LorcaSnep/Lorca-SVR-Smol/PCB Production Files/Charger/SVR Lorca Charger BOM.xlsx

Component | Manufacturer Part Number | Digikey Part Number | Mouser Part Number | Designator | Quantity
ATTINY3217-MFR | ATTINY3217-MFR | ATTINY3217-MFRCT-ND | 579-ATTINY3217-MFR | ATTINY | 1
STUSB4500LQTR | STUSB4500LQTR | 497-STUSB4500LQCT-ND | 511-STUSB4500LQTR | STUSB4500 | 1
TPS259631DDAR | TPS259631DDAR | 296-TPS259631DDARCT-ND | 595-TPS259631DDAR | FUSE | 1
APTF1616SURKCGKSYKC | APTF1616SURKCGKSYKC | 754-2149-1-ND | 604-APTF1616KCGKSYKC | LED | 1
MCP1703AT-3302E_CB | MCP1703AT-3302E/CB | MCP1703AT-3302E/CBCT-ND | 579-MCP1703AT3302ECB | 3V3 | 1
USB4105-GF-A | USB4105-GF-A | 2073-USB4105-GF-ACT-ND | 640-USB4105-GF-A | USB_DATA, USB_PWR, USB_RECEIVER | 3
105057-0001 | 1050570001 | WM8672-ND | 538-105057-0001 | RECEIVER | 1
TPD1E10B06DPYR | TPD1E10B06DPYR | 296-30406-1-ND | 595-TPD1E10B06DPYR | D1, D3, D4 | 3
SP0503BAHTG | SP0503BAHTG | F2715CT-ND | 576-SP0503BAHTG | D2, D5 | 2
5.1K 0402 Resistor | RK73H1ETTP5101F | 2019-RK73H1ETTP5101FCT-ND | 660-RK73H1ETTP5101F | R1, R2, R15, R16 | 4
620 Ohm 0402 Resistor | RK73H1ETTP6200F | 2019-RK73H1ETTP6200FCT-ND | 660-RK73H1ETTP6200F | R11 | 1
680 Ohm 0402 Resistor | RK73H1ETTP6800F | 2019-RK73H1ETTP6800FCT-ND | 660-RK73H1ETTP6800F | R9, R10 | 2
715 Ohm 1% 0402 Resistor | RK73H1ETTP7150F | 2019-RK73H1ETTP7150FCT-ND | 660-RK73H1ETTP7150F | R12 | 1
1K 0402 Resistor | RK73H1ETTP1001F | 2019-RK73H1ETTP1001FCT-ND | 660-RK73H1ETTP1001F | R3 | 1
10K 0402 Resistor | RK73H1ETTP1002D | 2019-RK73H1ETTP1002DCT-ND | 660-RK73H1ETTP1002D | R4, R5, R6, R7, R8 | 5
49.9K 0402 Resistor | RK73H1ETTP4992F | 2019-RK73H1ETTP4992FCT-ND | 660-RK73H1ETTP4992F | R14 | 1
200K 0402 Resistor | RK73H1ETTP2003F | 2019-RK73H1ETTP2003FCT-ND | 660-RK73H1ETTP2003F | R13 | 1
47nF X7R 10V 0402 Cap | GRM155R71H473KE14D | 490-10702-1-ND | 81-GRM155R71H473KE4D | C8 | 1
0.1uF 0402 Cap | GRT155R71C104KE01D | 490-GRT155R71C104KE01DCT-ND | 81-GRT155R71C104KE1D | C6, C7 | 2
1uF 0402 Cap | GRT155R61C105KE01D | 490-12255-1-ND | 81-GRT155R61C105KE1D | C1, C2, C5 | 3
C1608X7S1A475K080AC | C1608X7S1A475K080AC | 445-14258-1-ND | 810-C1608X7S1A475KAC | C3, C4 | 2
CL21B106KOQNNNE | CL21B106KOQNNNE | 1276-2872-1-ND | 187-CL21B106KOQNNNE | C9 | 1
GND Pogo Pin | 0908-4-15-20-75-14-11-0 | ED90387-ND | 575-0908415207514 | N/A | 11
Pogo Pin | 0908-3-15-20-75-14-11-0 | ED90417-ND | 575-0908315207514 | N/A | 23
