LorcaSnep/Lorca-SVR-Smol/PCB Production Files/LSM6DSVTR/SVR Lorca V5.0 LSM BOM.xlsx

Component | Manufacturer Part Number | Digikey Part Number | Mouser Part Number | Designator | Quantity
ISP1907-HT | ISP1907-HT | 1786-ISP1907-HT-RSTR-ND | 359-ISP1907-HT-JT | U1 | 1
BQ25185DLHR | BQ25185DLHR | 296-BQ25185DLHRCT-ND | 595-BQ25185DLHR | CHRG | 1
TPS628438DRLR | TPS628438DRLR | 296-TPS628438DRLRCT-ND | 595-TPS628438DRLR | 3V3 | 1
LSM6DSVTR | LSM6DSVTR | 497-LSM6DSVTRCT-ND | 511-LSM6DSVTR | LSM6DSVTR | 1
QMC6309 | QMC6309 | N/A | N/A | MAG | 1
ESDR0502NMUTBG | ESDR0502NMUTBG | ESDR0502NMUTBGOSCT-ND | 863-ESDR0502NMUTBG | USB_PR | 1
TPD1E05U06DPYR | TPD1E05U06DPYR | 296-39341-1-ND | 595-TPD1E05U06DPYR | PWR_PR | 1
ASMB-LTB2-0A333 | ASMB-LTB2-0A333 | 516-4289-1-ND | 630-ASMB-LTB2-0A333 | CHRG_LED | 1
PTS815SJK250SMTR_LFS | PTS815SJK250SMTRLFS | CKN12216-1-ND | 611-PTS815SJK250SMTR | SW0 | 1
EVP-BB1AAB000 | EVP-BB1AAB000 | P124390CT-ND | 667-EVP-BB1AAB000 | RST | 1
CSD17484F4 | CSD17484F4 | 296-47319-1-ND | 595-CSD17484F4 | Q1 | 1
DFE201610E-1R0M=P2 | DFE201610E-1R0M=P2 | 490-18106-1-ND | 81-DFE201610E-1R0MP2 | L1 | 1
781710002 | 781710002 | WM4459CT-ND | 538-78171-0002 | BAT | 1
470 Ohm 5% 0402 | RK73H1ETTP4700F | 2019-RK73H1ETTP4700FCT-ND | 660-RK73H1ETTP4700F | R15 | 1
680 Ohm 5% 0402 | RK73H1ETTP6800F | 2019-RK73H1ETTP6800FCT-ND | 660-RK73H1ETTP6800F | R7 | 1
1K Ohm 5% 0402 | RK73H1ETTP1001F | 2019-RK73H1ETTP1001FCT-ND | 660-RK73H1ETTP1001F | R8, R10 | 2
4.02K Ohm 5% 0402 | RK73H1ETTP4021F | 2019-RK73H1ETTP4021FCT-ND | 660-RK73H1ETTP4021F | R5 | 1
10K Ohm 5% 0402 | RK73H1ETTP1002D | 2019-RK73H1ETTP1002DCT-ND | 660-RK73H1ETTP1002D | R1, R3, R13, R14, R16 | 5
24K Ohm 5% 0402 | RK73H1ETTP2402F | 2019-RK73H1ETTP2402FCT-ND | 660-RK73H1ETTP2402F | R4 | 1
100K Ohm 5% 0402 | RK73H1ETTP1003F | 2019-RK73H1ETTP1003FCT-ND | 660-RK73H1ETTP1003F | R9, R12 | 2
180K 0402 Resistor | RK73H1ETTP1803F | 2019-RK73H1ETTP1803FCT-ND | 660-RK73H1ETTP1803F | R11 | 1
255K Ohm 5% 0402 | RK73H1ETTP2553F | 2019-RK73H1ETTP2553FCT-ND | 660-RK73H1ETTP2553F | R6 | 1
0.1uF 0402 | GRT155R71C104KE01D | 490-GRT155R71C104KE01DCT-ND | 81-GRT155R71C104KE1D | C3, C10 | 2
1uF 0402 | GRT155R61C105KE01D | 490-12255-1-ND | 81-GRT155R61C105KE1D | C11 | 1
4.7uF 0402 | GRT155R61A475ME13D | 490-GRT155R61A475ME13DCT-ND | 81-GRT155R61A475ME13 | C4, C5, C6 | 3
10uF 0402 | GRT155R61A106ME13J | 490-GRT155R61A106ME13JCT-ND | 81-GRT155R61A16ME13J | C1, C2, C7, C8, C9 | 5
