LorcaSnep/Lorca-SVR-Smol/PCB Production Files/Lorca SVR Smol V1.5.xlsx

Component | Manufacturer Part Number | Digikey Part Number | Designator | Quantity | Feeder Reel Size (mm)
ISP1807 | ISP1807-LR-RS | 1786-1019-1-ND | U1 | 1 | 16
LSM6DSVTR | LSM6DSVTR | 497-LSM6DSVTRCT-ND | IMU | 1 | 12 | Reel Width (mm) | Total
IST8306 | iST8306 | 5750-iST8306TR-ND | MAG | 1 | 8 | 8 | 15
BQ24075RGTR | BQ24075RGTR | 296-38874-1-ND | BAT_CHRG | 1 | 12 | 12 | 2
ADP2108ACBZ-3.3-R7 | ADP2108ACBZ-3.3-R7 | ADP2108ACBZ-3.3-R7CT-ND | 3V3 | 1 | 8 | 16 | 2
ESDR0502NMUTBG | ESDR0502NMUTBG | ESDR0502NMUTBGOSCT-ND | USB_PR | 1 | 8
B3U-1000P | B3U-1000P | SW1020CT-ND | SW0 | 1 | 8
ASMB-LTB2-0A333 | ASMB-LTB2-0A333 | 516-4289-1-ND | CHRG_LED | 1 | 8
150040BS73240 | 150040BS73240 | 732-11989-1-ND | STATUS_LED | 1 | 8
781710002 | 781710002 | WM4459CT-ND | BAT | 1 | 16
1N5819W | 1N5819W | 1655-1N5819WCT-ND | D1 | 1 | 8
LQM21PN1R0MC0D | LQM21PN1R0MC0D | 490-4992-1-ND | L2 | 1 | 8
100nF 0402 | GRT155R71C104KE01D | 490-GRT155R71C104KE01DCT-ND | C6, C8 | 2 | 8
4.7uF 0402 | GRT155R61A475ME13D | 490-GRT155R61A475ME13DCT-ND | C1, C2, C10 | 3 | 8
10uF 0402 | GRT155R61A106ME13J | 490-GRT155R61A106ME13JCT-ND | C5, C7, C9, C11 | 4 | 8
1K Ohm 5% 0402 | RK73H1ETTP1001F | 2019-RK73H1ETTP1001FCT-ND | R13 | 1 | 8
10K Ohm 5% 0402 | RK73H1ETTP1002D | 2019-RK73H1ETTP1002DCT-ND | R3, R4, R5, R6, R7, R11, R16, R17 | 8 | 8
100K Ohm 5% 0402 | RK73H1ETTP1003F | 2019-RK73H1ETTP1003FCT-ND | R10, R12 | 2 | 8
180K Ohm 5% 0402 | RK73H1ETTP1803F | 2019-RK73H1ETTP1803FCT-ND | R9 | 1 | 8
