LorcaSnep/Lorca-SVR-Smol/3D Files/Tracker/Main Body Lower.step

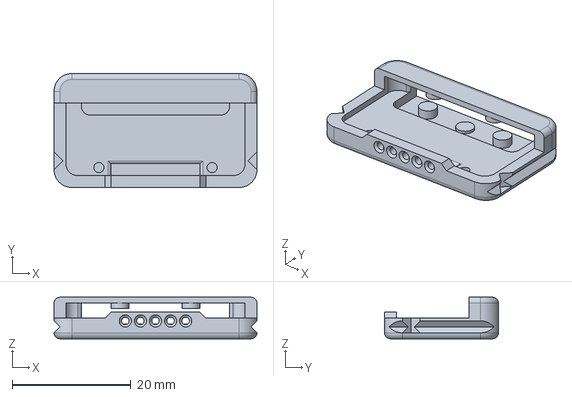
[picture p9: CAD file, 2026-10-28]
3D Files/Tracker/Main Body Lower.step
34.2 x 19.2 x 7.00 mm
