LorcaSnep/Lorca-SVR-Smol/Main Body Upper.step

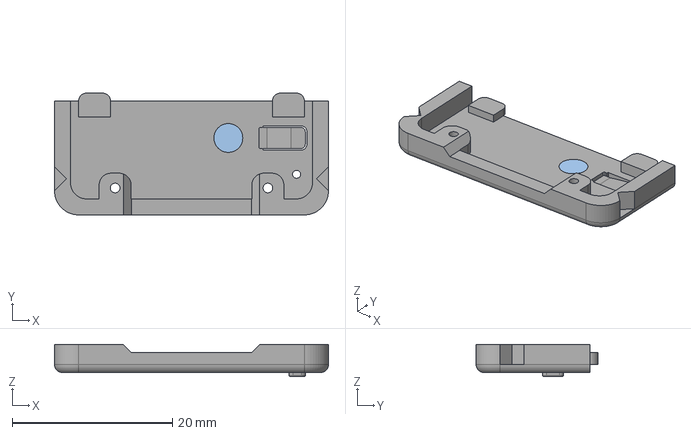
[picture p10: CAD file, 2026-10-28]
Main Body Upper.step
34.2 x 15.2 x 4.00 mm
