LorcaSnep/Lorca-SVR-Smol/3D Files/Charger/Charger Body.step

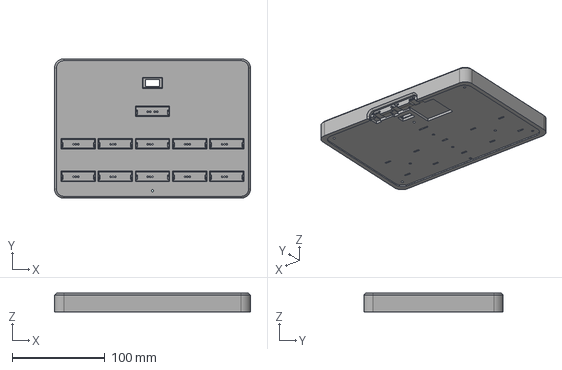
[picture p11: CAD file, 2026-10-28]
3D Files/Charger/Charger Body.step
211.0 x 150.0 x 20.0 mm
