LorcaSnep/Lorca-SVR-Smol/3D Files/Tracker/Bridge V4.step

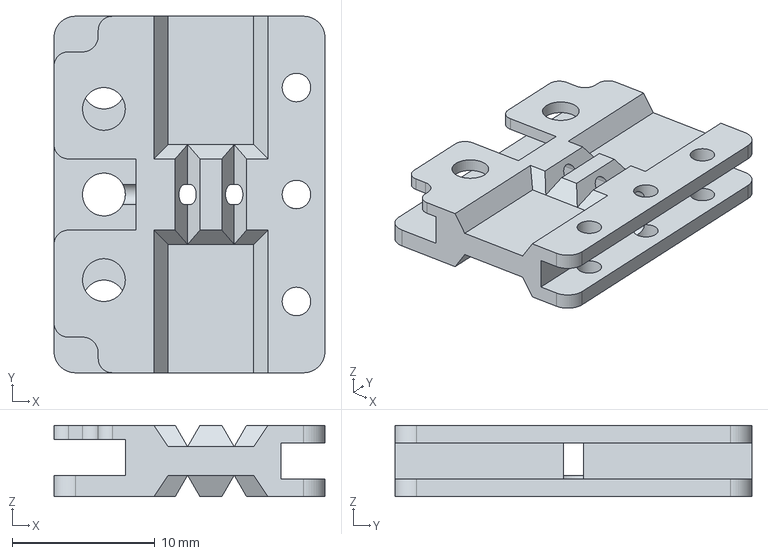
[picture p12: CAD file, 2026-10-28]
3D Files/Tracker/Bridge V4.step
19.0 x 25.0 x 5.00 mm
