LorcaSnep/Lorca-SVR-Smol/Charger Body Bottom Cover.step

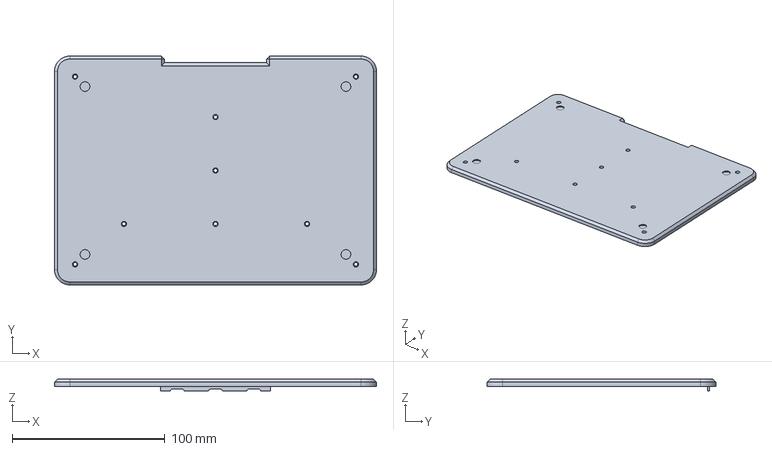
[picture p13: CAD file, 2026-10-28]
Charger Body Bottom Cover.step
211.0 x 150.0 x 7.93 mm
