LorcaSnep/Lorca-SVR-Smol/Battery Body Upper.step

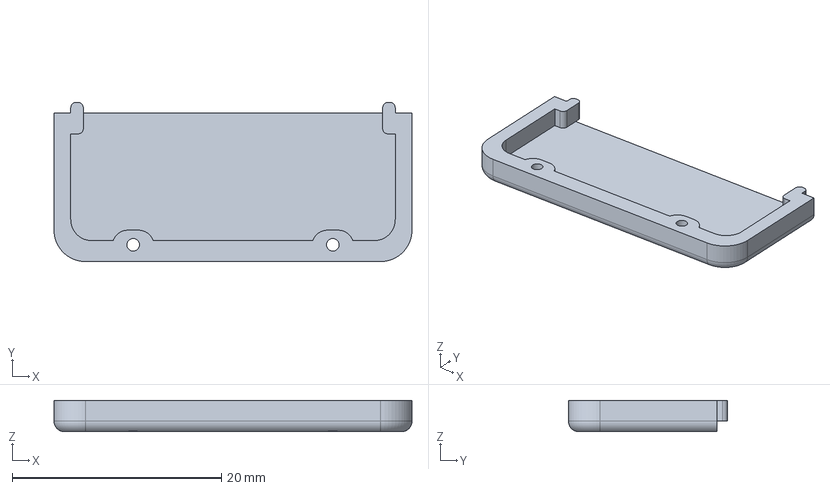
[picture p14: CAD file, 2026-10-28]
Battery Body Upper.step
34.2 x 15.2 x 3.00 mm
