LorcaSnep/Lorca-SVR-Smol/(list of files, cad)

Other CAD files:
3D Files/Tracker/Battery Body Lower.step
