LorcaSnep/Lorca-SVR-Smol/PCB Production Files/LSM6DSVTR/SVR Smol Lorca V5.0 LSM.pdf

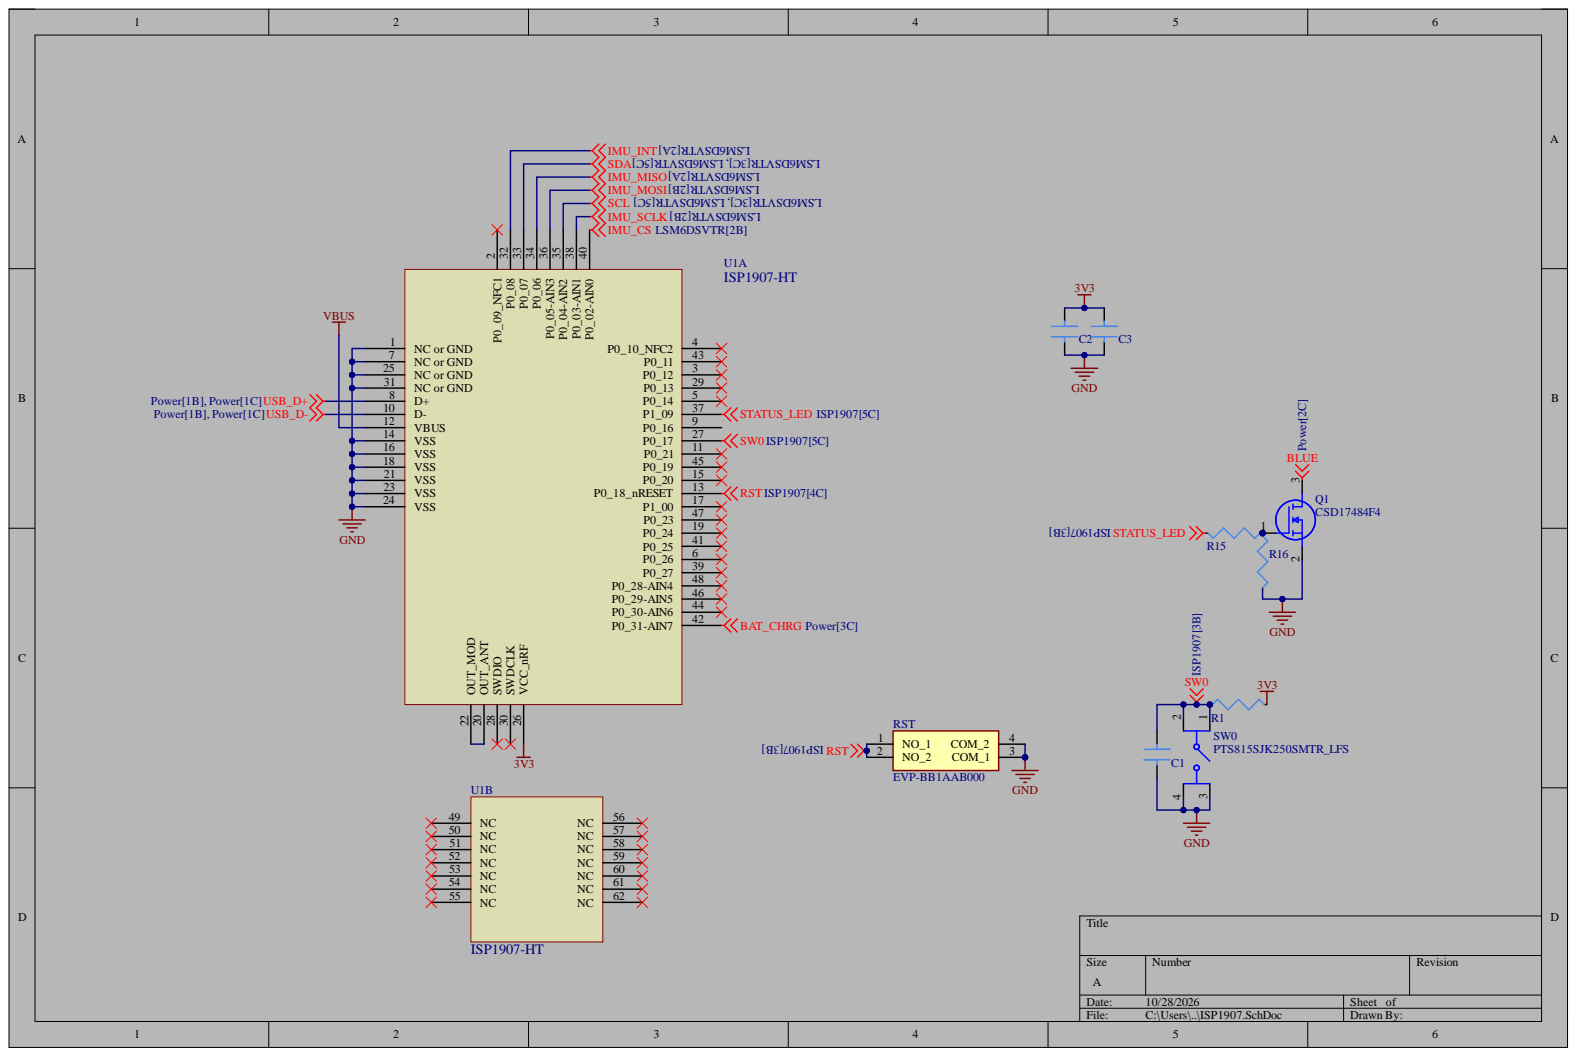
[picture p15: page 1]

IMU_SCLK ] B2[ RTVS D6 MSL SCL ] C5[ RTVS D6 MSL,] C3[ RTVS D6 MSL IMU_MOSI ] B2[ RTVS D6 MSL IMU_MISO ] A2[ RTVS D6 MSL SDA ] C5[ RTVS D6 MSL,] C3[ RTVS D6 MSL IMU_INT ] A2[ RTVS D6 MSL

NC or GND 7
NC or GND 25
NC or GND 31
D+ 8 D- 10 VBUS 12

Size A | Number | Revision

Date: 10/28/2026 | Sheet of
File: C:\Users\..\ISP1907.SchDoc | Drawn By:

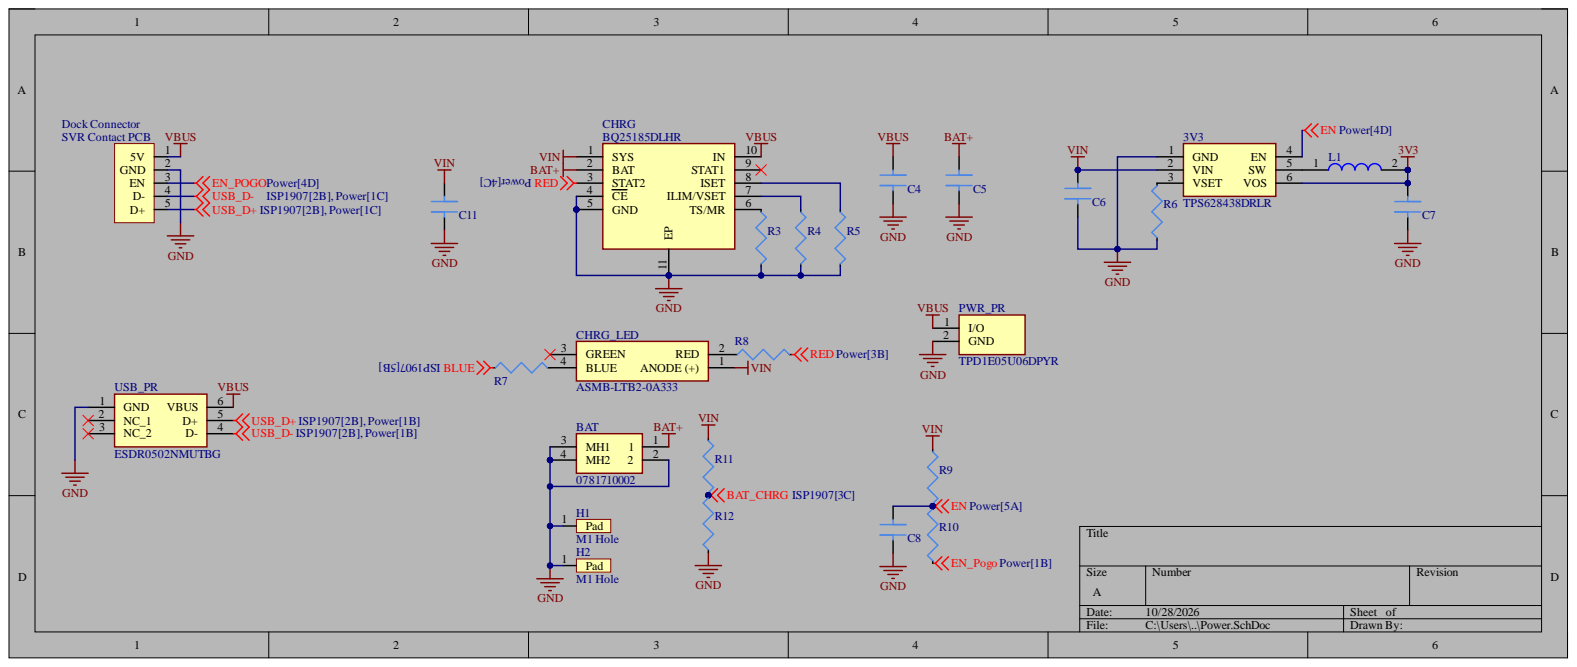
[picture p16: page 2]

Date: 1 0/2 8 /2 0 2 6 | Sheet o f
File: C:\User s\. .\Power .Sch D o c | Drawn B y :

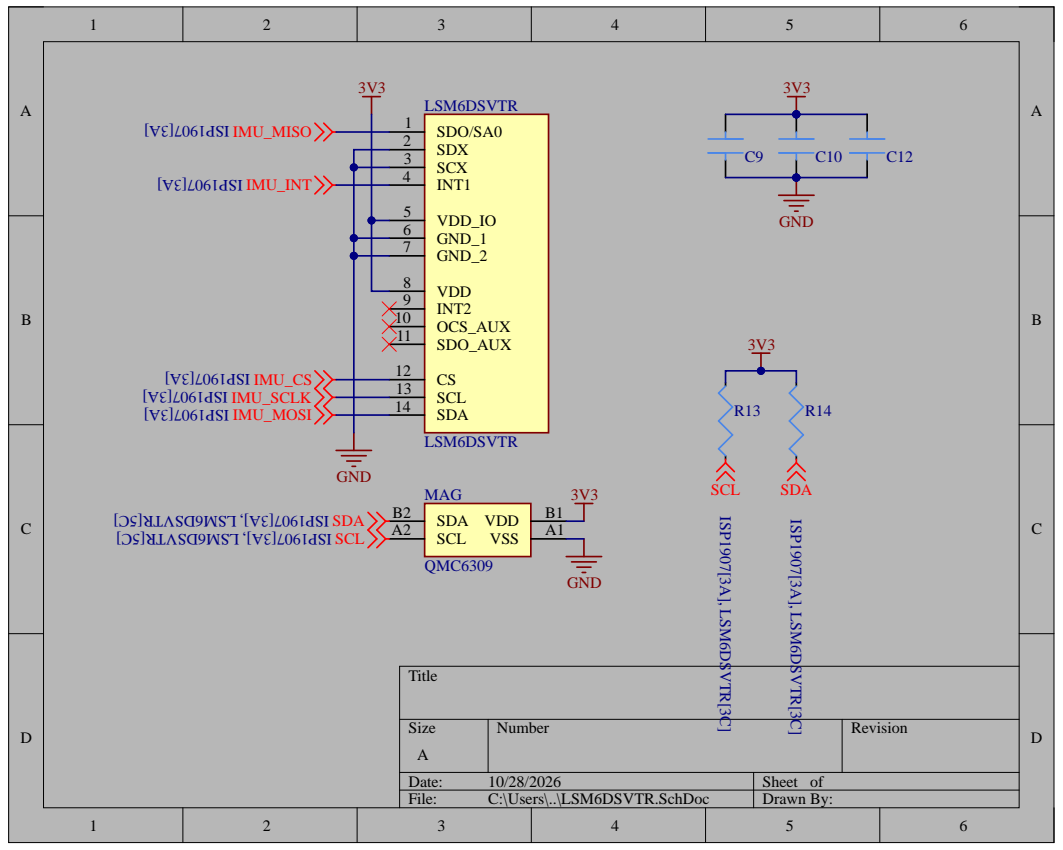
[picture p17: page 3]

SCX 3
INT1 4 VDD_IO 5

GND_1 6

VDD 8

Size A | Number | Revision

Date: 10/28/2026 | Sheet of
File: C:\Users\..\LSM6DSVTR.SchDoc | Drawn By:
