LorcaSnep/Lorca-SVR-Smol/PCB Production Files/ICM-45686/SVR Smol Lorca V5.0 ICM.pdf

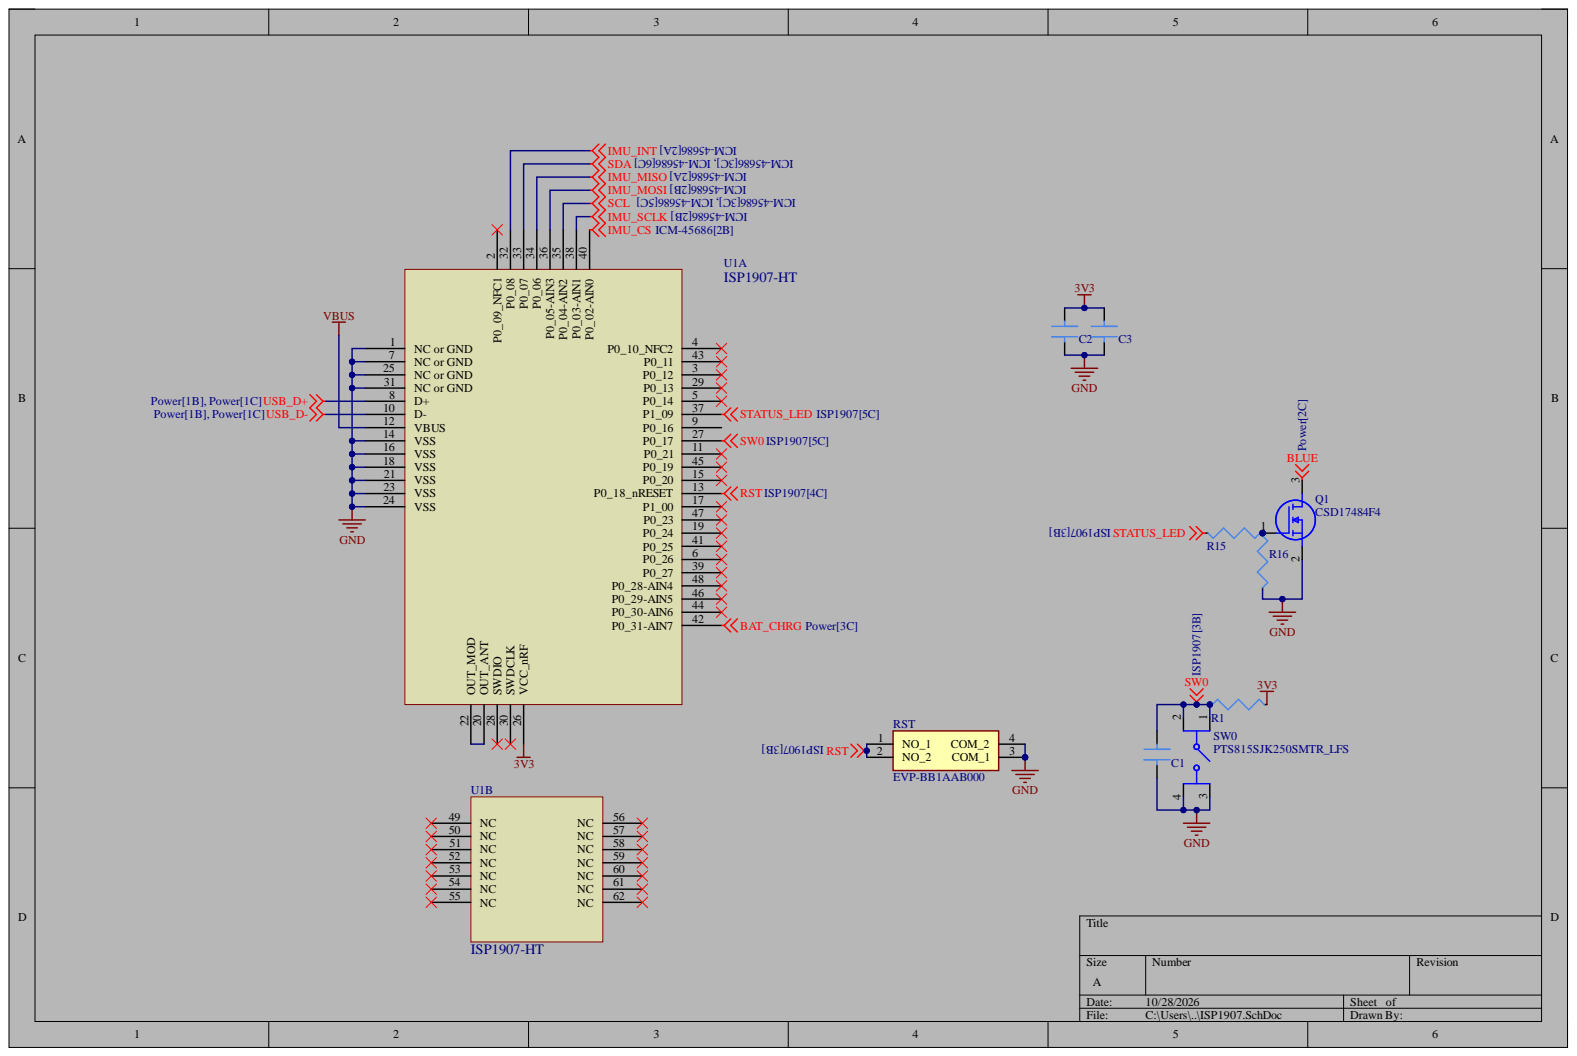
[picture p18: page 1]

IMU_SCLK ] B2[ 68654- MCI SCL ] C5[ 68654- MCI,] C3[ 68654- MCI IMU_MOSI ] B2[ 68654- MCI IMU_MISO ] A2[ 68654- MCI SDA ] C6[ 68654- MCI,] C3[ 68654- MCI IMU_INT ] A2[ 68654- MCI

NC or GND 7
NC or GND 25
NC or GND 31
D+ 8 D- 10 VBUS 12

Size A | Number | Revision

Date: 10/28/2026 | Sheet of
File: C:\Users\..\ISP1907.SchDoc | Drawn By:


Date: 1 0/2 8 /2 0 2 6 | Sheet o f
File: C:\User s\. .\Power .Sch D o c | Drawn B y :

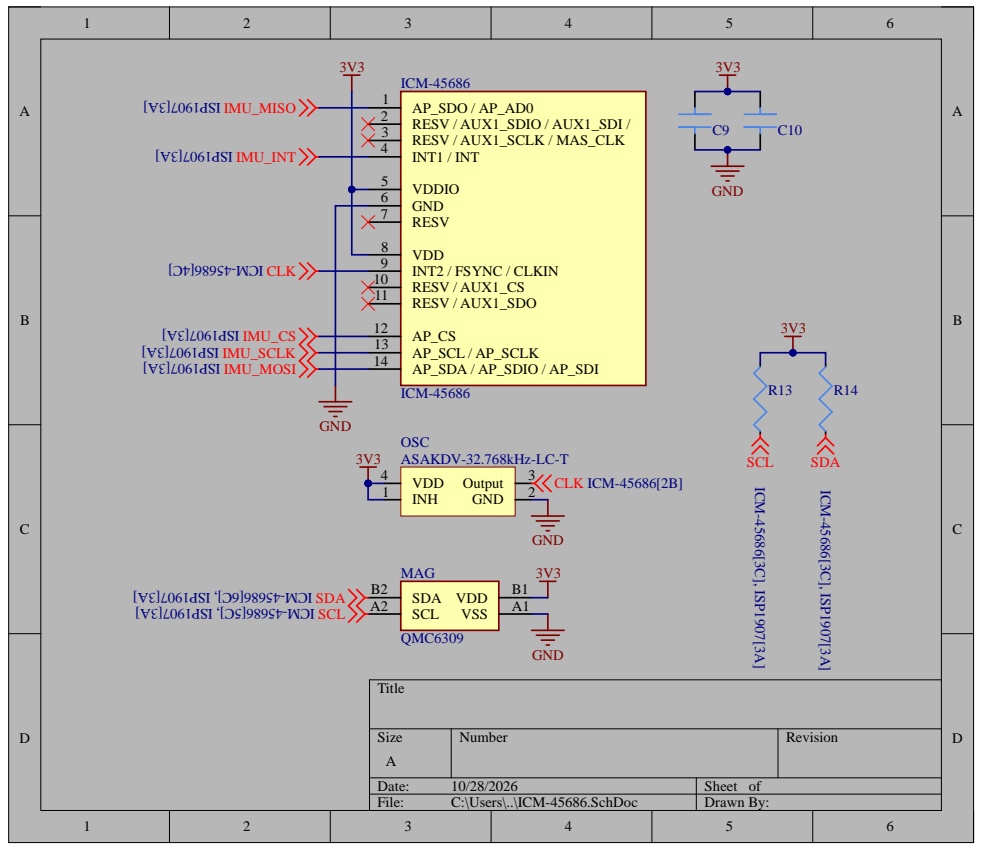
[picture p19: page 3]

Size A | Number | Revision

Date: 10/28/2026 | Sheet of
File: C:\Users\..\ICM-45686.SchDoc | Drawn By:
