LorcaSnep/Lorca-SVR-Smol/PCB Production Files/Charger/SVR Smol Lorca Charger.pdf

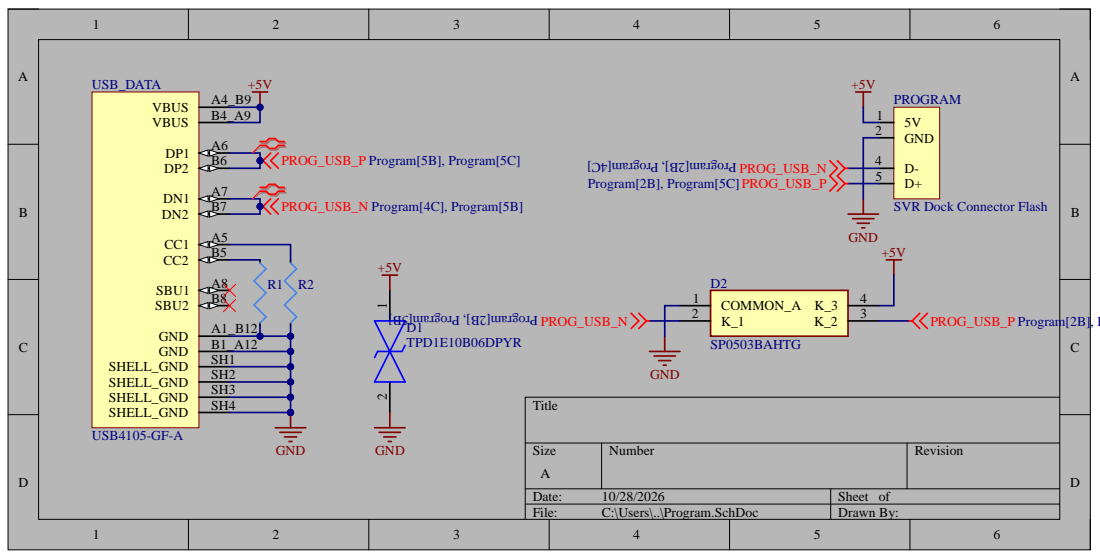
[picture p20: page 1]

Size A | Number | Revisio n

Date: 1 0/2 8/2 0 2 6 | Sheet o f
File: C:\Users\..\Pro gram.SchDo c | Drawn By :

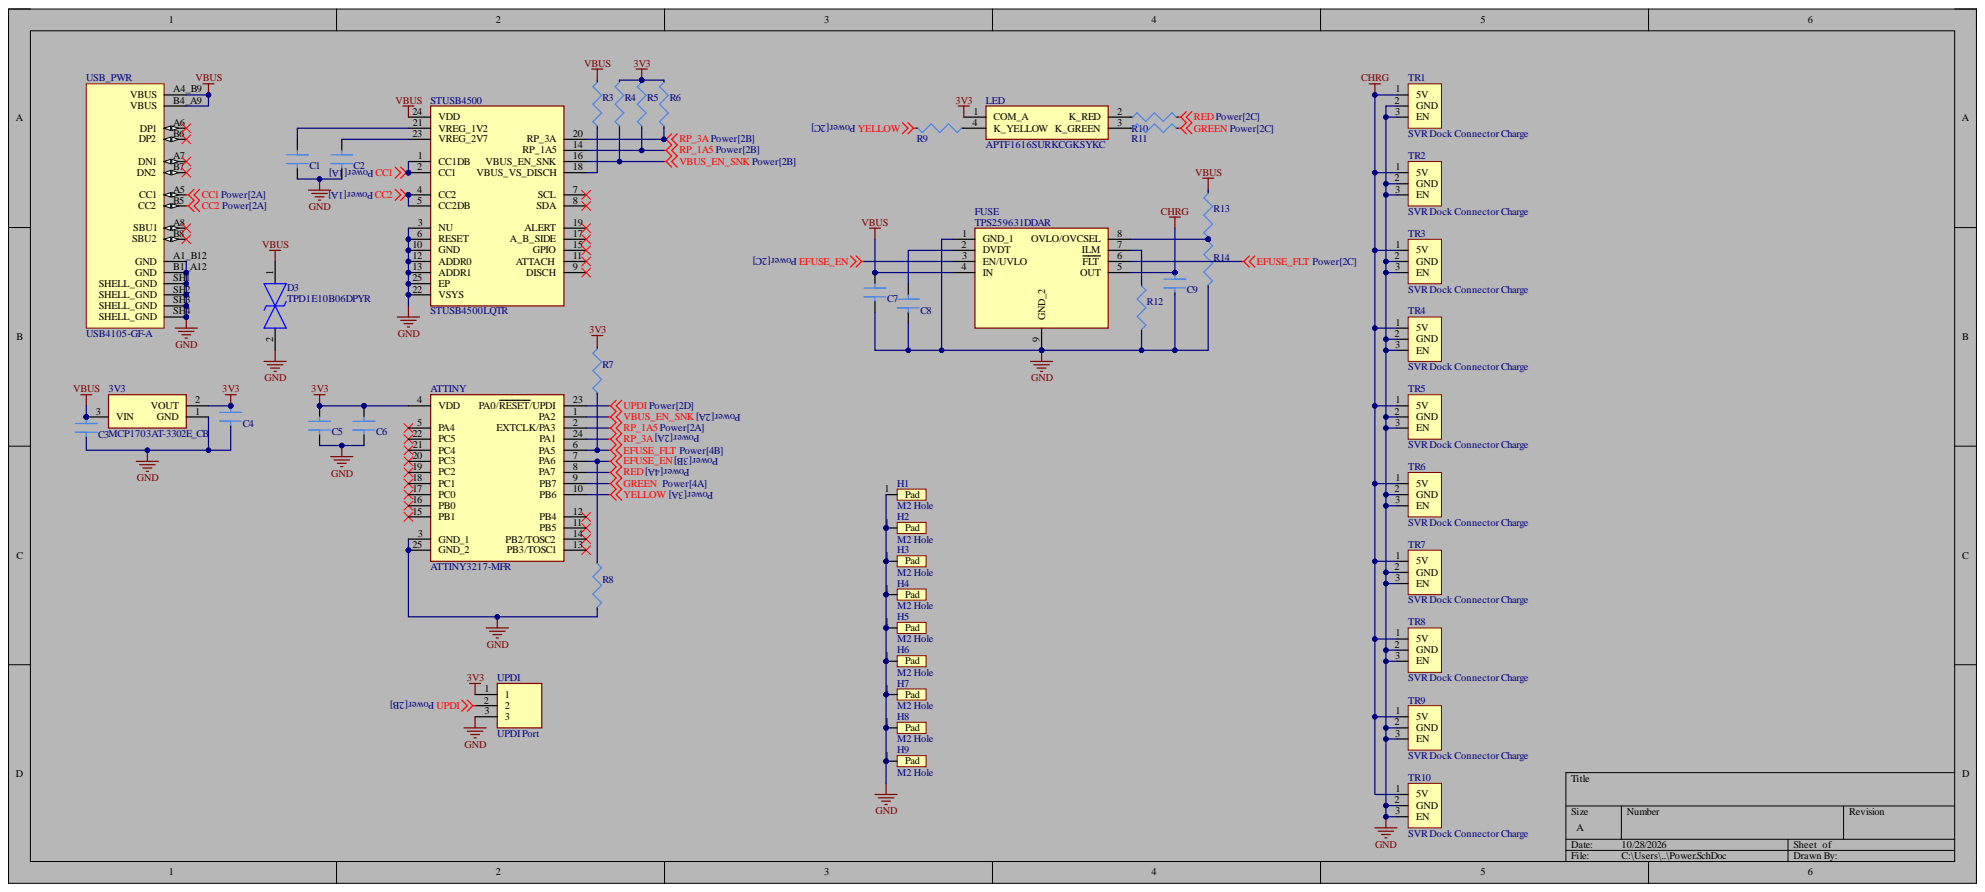
[picture p21: page 2]

: 1 0 /2 8 /2 0 2 6 | S h e e t o f
Fi l e : C : \ U s e r s \ . . \ P o w e r. S c hDo c | D r a w n B y :

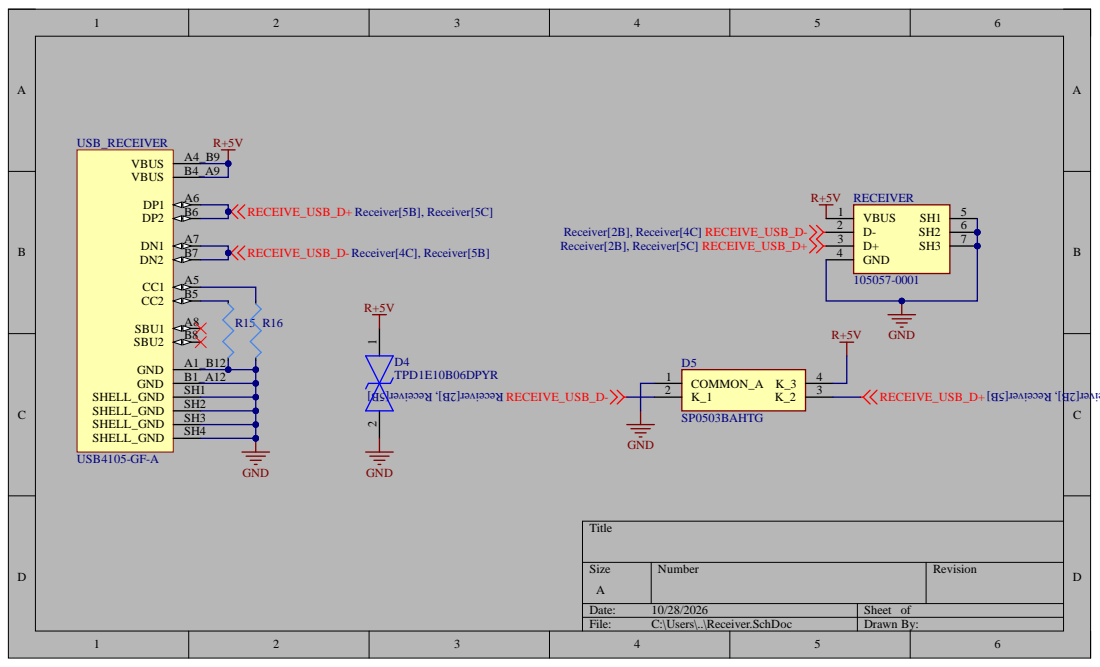
[picture p22: page 3]

A | e r | Re visio n

Date : 1 0/2 8/2 0 2 6 | S h e et o f
File : C:\Us ers\..\Re c eiv e r.S c hDo c | Drawn By :
