LorcaSnep/Lorca-SVR-Smol/(commit log)

2026-03-02 Rename Lorca SVR Smol Contact PCB.zip to PCB Production Files/Lorca SVR Smol Contact PCB.zip
2026-03-02 Rename Lorca SVR Smol LSM6DSV V1.5.zip to PCB Production Files/Lorca SVR Smol LSM6DSV V1.5.zip
2026-03-02 Rename Lorca SVR Smol PCB Back.PNG to Images/Lorca SVR Smol PCB Back.PNG
2026-03-02 Rename Lorca SVR Smol PCB Front.PNG to Images/Lorca SVR Smol PCB Front.PNG
2026-03-03 Update README with current PCB design information
    Added section for current PCB design with images.
2026-10-01 Rename SVR Lorca PCB Back.PNG to Images/SVR Lorca PCB Back.PNG
2026-10-01 Rename SVR Lorca PCB Front.PNG to Images/SVR Lorca PCB Front.PNG
2026-10-01 Update PCB image links in README.md
2026-10-21 Rename Images/SVR Lorca PCB Front.PNG to Images/delete/SVR Lorca PCB Front.PNG
2026-10-21 Rename Images/delete/SVR Lorca PCB Front.PNG to Images/SVR Lorca PCB Front.PNG
2026-10-21 Revise PCB design sections and add complete design images
    Updated section headers and added current complete design images.
2026-10-28 Rename PCB Production Files/SVR Lorca V5.0 ICM BOM.xlsx to PCB Production Files/ICM-45686/SVR Lorca V5.0 ICM BOM.xlsx
2026-10-28 Rename PCB Production Files/SVR Lorca V5.0 LSM BOM.xlsx to PCB Production Files/LSM6DSVTR/SVR Lorca V5.0 LSM BOM.xlsx
2026-10-28 Rename PCB Production Files/SVR Lorca Charger BOM.xlsx to PCB Production Files/Charger/SVR Lorca Charger BOM.xlsx
2026-10-28 Rename Battery Body Lower.step to 3D Files/Tracker/Battery Body Lower.step
2026-10-28 Rename Battery Body Upper.step to 3D Files/Tracker/Battery Body Upper.step
2026-10-28 Rename Charger Body.step to 3D Files/Charger/Charger Body.step
2026-10-28 Rename Charger Body Bottom Cover.step to 3D Files/Charger/Charger Body Bottom Cover.step
